paleksey/Automated-Blinds/enclosure/motor enclosure/render-2.png

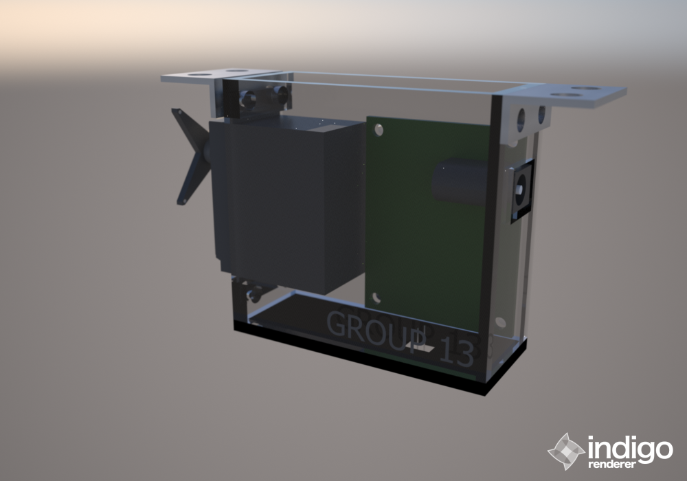
enclosure/motor enclosure/render-2.png
