paleksey/Automated-Blinds/enclosure/motor enclosure/render-1.png

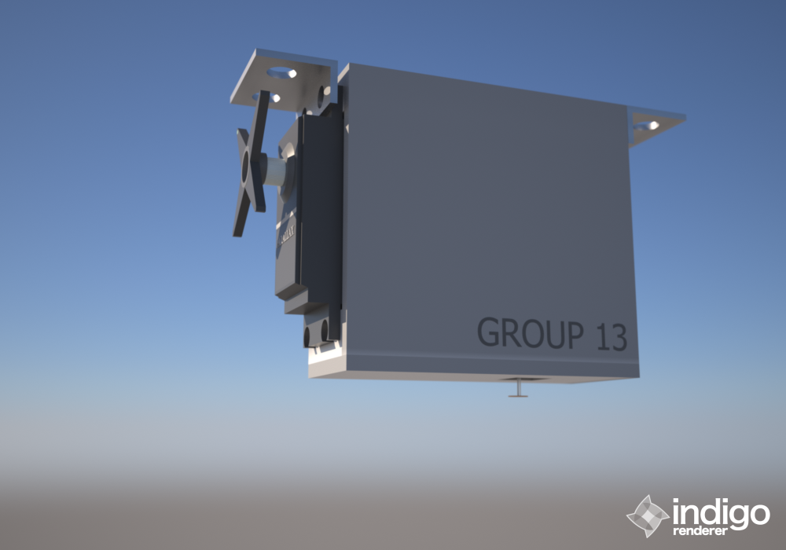
enclosure/motor enclosure/render-1.png
