paleksey/Automated-Blinds/README.md

# Automated-Blinds
This is a project design where we will design and build blinds that close and open automatically based on the light intensity outside.
