paleksey/Automated-Blinds/documents/T13-HOMEWORK-4.pdf

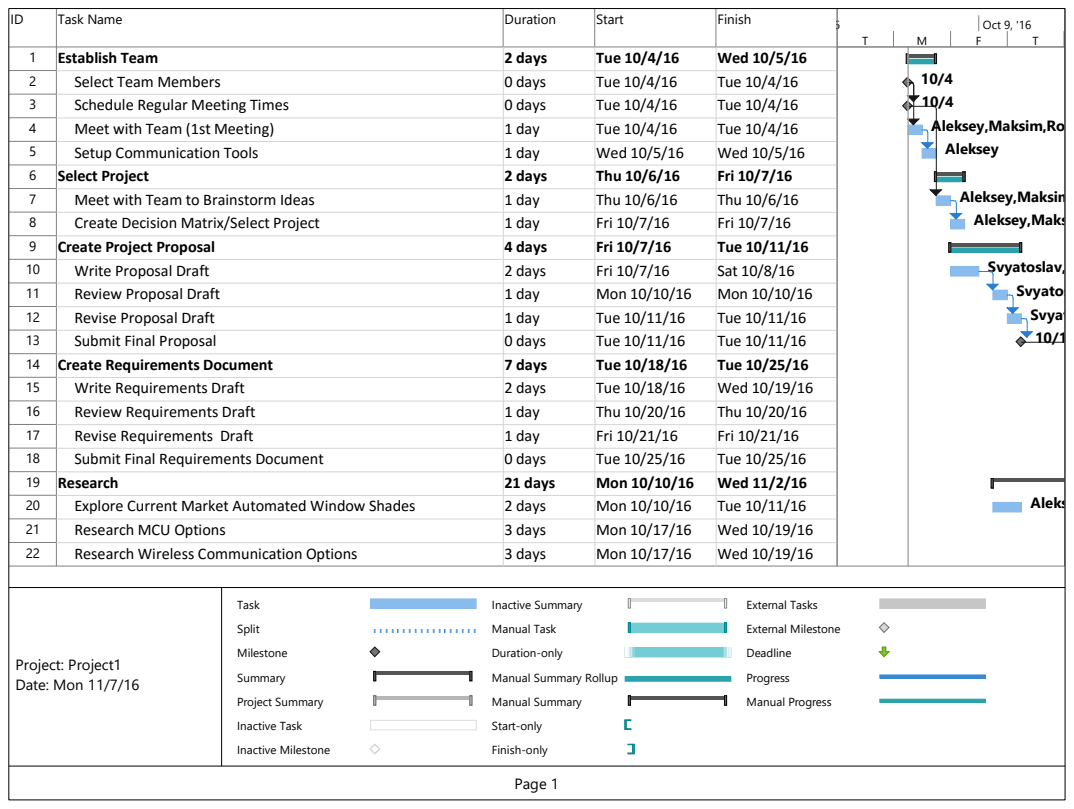
[picture p6: page 1]
Task Name; Duration; Start; Finish; Establish Team; 2 days; Tue 10/4/16; Wed 10/5/16; Select Team Members; 0 days; Schedule Regular Meeting Times; Meet with Team (1st Meeting); 1 day; Setup Communication Tools; Select Project; Thu 10/6/16; Fri 10/7/16; Meet with Team to Brainstorm Ideas; Create Decision Matrix/Select Project; Create Project Proposal; 4 days; Tue 10/11/16; Write Proposal Draft; Sat 10/8/16; Review Proposal Draft; Mon 10/10/16; Revise Proposal Draft; Submit Final Proposal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

Aleksey,Maksim,Roman,Svyatoslav
Aleksey,Maksim,Roman

Manual Summary Rollup

23 | Research Window Shades Actuator Options | 1 day | Thu 10/27/16 | Thu 10/27/16
24 | Research Schematic Capture Software Options | 1 day | Mon 10/10/16 | Mon 10/10/16
25 | Research MCU Programing Tools | 3 days | Mon 10/31/16 | Wed 11/2/16
26 | Design Window Shade Mechanism | 8 days | Fri 10/21/16 | Fri 10/28/16
27 | Brainstorm Enclosure/Mechanism Ideas | 3 days | Fri 10/21/16 | Sun 10/23/16
28 | Draw Concept Sketches | 2 days | Mon 10/24/16 | Tue 10/25/16
29 | Meet with Team to Select Final Mechanism Approach | 1 day | Wed 10/26/16 | Wed 10/26/16
30 | Create 3D Model of PCB Enclosure | 2 days | Thu 10/27/16 | Fri 10/28/16
31 | Create 3D Model of Demo Unit | 1 day | Thu 10/27/16 | Thu 10/27/16
32 | Design Preliminary Schematic | 11 days | Fri 10/14/16 | Wed 10/26/16
33 | Download Schematic Capture Software | 1 day | Fri 10/14/16 | Fri 10/14/16
34 | Create Functional Block Diagram for Circuit | 2 days | Mon 10/24/16 | Tue 10/25/16
35 | Create Preliminary Schematic | 7 days | Thu 10/20/16 | Wed 10/26/16
36 | Design PCB Power Circuit | 1 day | Wed 10/26/16 | Wed 10/26/16
37 | Design MCU Operation Circuit | 1 day | Thu 10/20/16 | Thu 10/20/16
38 | Design Device I/O Circuitry | 1 day | Fri 10/21/16 | Fri 10/21/16
39 | Select Prototyping Parts | 2 days | Sat 10/22/16 | Sun 10/23/16
40 | Create Prototyping BOM | 1 day | Mon 10/24/16 | Mon 10/24/16
41 | Order Prototyping Parts | 1 day | Tue 10/25/16 | Tue 10/25/16
42 | Prototype Project | 8 days | Wed 10/26/16 | Thu 11/3/16
43 | Build Prototype | 3 days | Wed 10/26/16 | Fri 10/28/16
44 | Test Basic Functionality | 2 days | Sun 10/30/16 | Mon 10/31/16

Svyatoslav

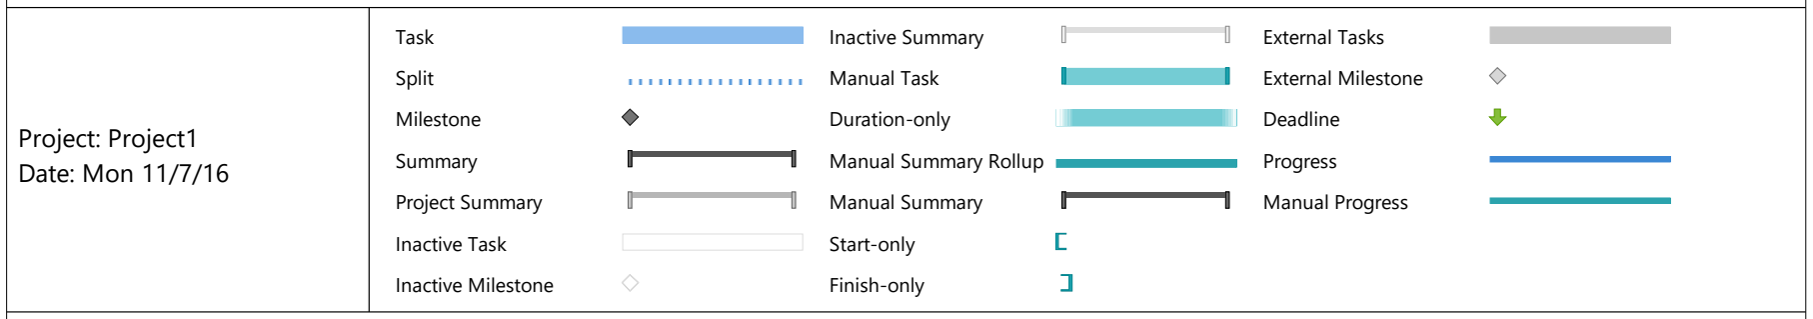
[picture p7: figure]
Task; Split; Milestone; Summary; Project Summary; Inactive Task; Inactive Milestone; Inactive Summary; Manual Task; Duration-only; Manual Summary Rollup; Manual Summary; Start-only; Finish-only; External Tasks; External Milestone; Deadline; Progress; Manual Progress; Project: Project1 Date: Mon 11/7/16

45 | Setup and Test Programing Tool | 2 days | Wed 10/26/16 | Thu 10/27/16
46 | Interface each Sensor and Actuator with MCU | 4 days | Mon 10/31/16 | Thu 11/3/16
47 | Revise Schematic Based on Prototyping | 1 day | Tue 11/1/16 | Tue 11/1/16
48 | Review Revised Schematic | 1 day | Wed 11/2/16 | Wed 11/2/16
49 | Upload Final Schematic | 0 days | Thu 11/3/16 | Thu 11/3/16
50 | Design PCB | 15 days | Fri 11/4/16 | Tue 11/22/16
51 | Select PCB Components | 4 days | Fri 11/4/16 | Tue 11/8/16
52 | Create PCB BOM | 1 day | Wed 11/9/16 | Wed 11/9/16
53 | Import Part Symbols and Footprints into Schematic Capture Tool | 2 days | Thu 11/10/16 | Fri 11/11/16
54 | Determine PCB Size | 1 day | Thu 11/10/16 | Thu 11/10/16
55 | Layout PCB | 3 days | Sat 11/12/16 | Tue 11/15/16
56 | Review Layout | 2 days | Wed 11/16/16 | Thu 11/17/16
57 | Route PCB | 2 days | Fri 11/18/16 | Mon 11/21/16
58 | Review Routing | 1 day | Tue 11/22/16 | Tue 11/22/16
59 | Review Gerber Files | 1 day | Tue 11/22/16 | Tue 11/22/16
60 | Submit PCB Files for Ordering | 0 days | Tue 11/22/16 | Tue 11/22/16
61 | Program MCU | 13 days | Wed 11/9/16 | Thu 11/24/16
62 | Write Pseudocode | 3 days | Wed 11/9/16 | Fri 11/11/16
63 | Translate Code to MCU Programing Language | 5 days | Sat 11/12/16 | Thu 11/17/16
64 | Run Code on Prototype Setup | 1 day | Fri 11/18/16 | Fri 11/18/16
65 | Debug Code | 3 days | Mon 11/21/16 | Wed 11/23/16
66 | Revise Code | 1 day | Thu 11/24/16 | Thu 11/24/16
| Task
| Split
| Milestone
| Summary
| Project Summary
| Inactive Task
| Inactive Milestone

Inactive Summary

Manual Task

Duration-only

Manual Summary Rollup

Manual Summary

Start-only

Finish-only

External Tasks

External Milestone

Deadline

Progress

Manual Progress

Project: Project1
Date: Mon 11/7/16

67 | Assemble Boards | 2 days | Wed 11/23/16 | Thu 11/24/16
68 | Assemble Window Shades for Demo | 4 days | Fri 11/25/16 | Wed 11/30/16
69 | Create PCB Enclosure | 2 days | Fri 11/25/16 | Mon 11/28/16
70 | Build Window Shade Mechanism | 2 days | Tue 11/29/16 | Wed 11/30/16
71 | Verify Project Requirements Have Been Met | 2 days | Thu 12/1/16 | Fri 12/2/16
72 | Test Ease of Use | 1 day | Thu 12/1/16 | Thu 12/1/16
73 | Conduct Stress Testing | 1 day | Thu 12/1/16 | Thu 12/1/16
74 | Test Long Term Functionality | 2 days | Thu 12/1/16 | Fri 12/2/16
75 | Create Final Project Documentation | 2 days | Mon 12/5/16 | Tue 12/6/16
76 | Review Documents | 1 day | Mon 12/5/16 | Mon 12/5/16
77 | Revise Documents | 1 day | Tue 12/6/16 | Tue 12/6/16
78 | Submit Final Documents | 0 days | Tue 12/6/16 | Tue 12/6/16
79 | Present Project | 1 day | Wed 12/7/16 | Wed 12/7/16

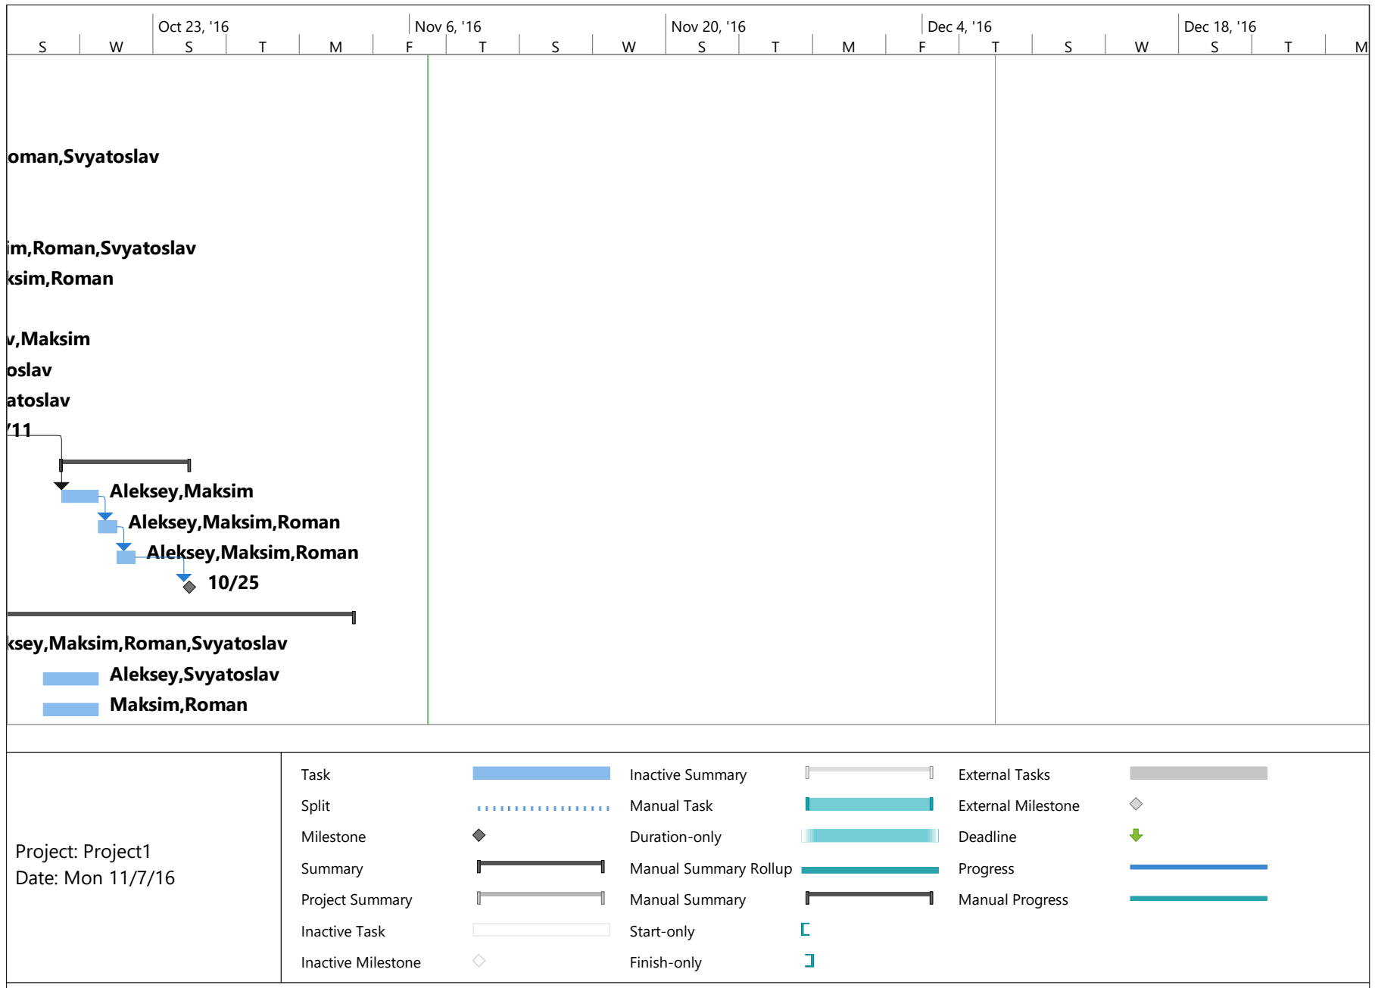
[picture p8: figure]
Aleksey,Maksim,Roman,Svyatoslav; Aleksey,Maksim,Roman; Svyatoslav,Maksim; Svyatoslav; Aleksey,Maksim; Aleksey,Svyatoslav; Maksim,Roman; Oct 23, '16; Nov 6, '16; Nov 20, '16; Dec 4, '16; Dec 18, '16; Task; Split; Milestone; Summary; Project Summary; Inactive Task; Inactive Milestone; Inactive Summary; Manual Task; Duration-only; Manual Summary Rollup; Manual Summary; Start-only; Finish-only; External Tasks; External Milestone; Deadline; Progress; Manual Progress; Project: Project1 Date: Mon 11/7/16
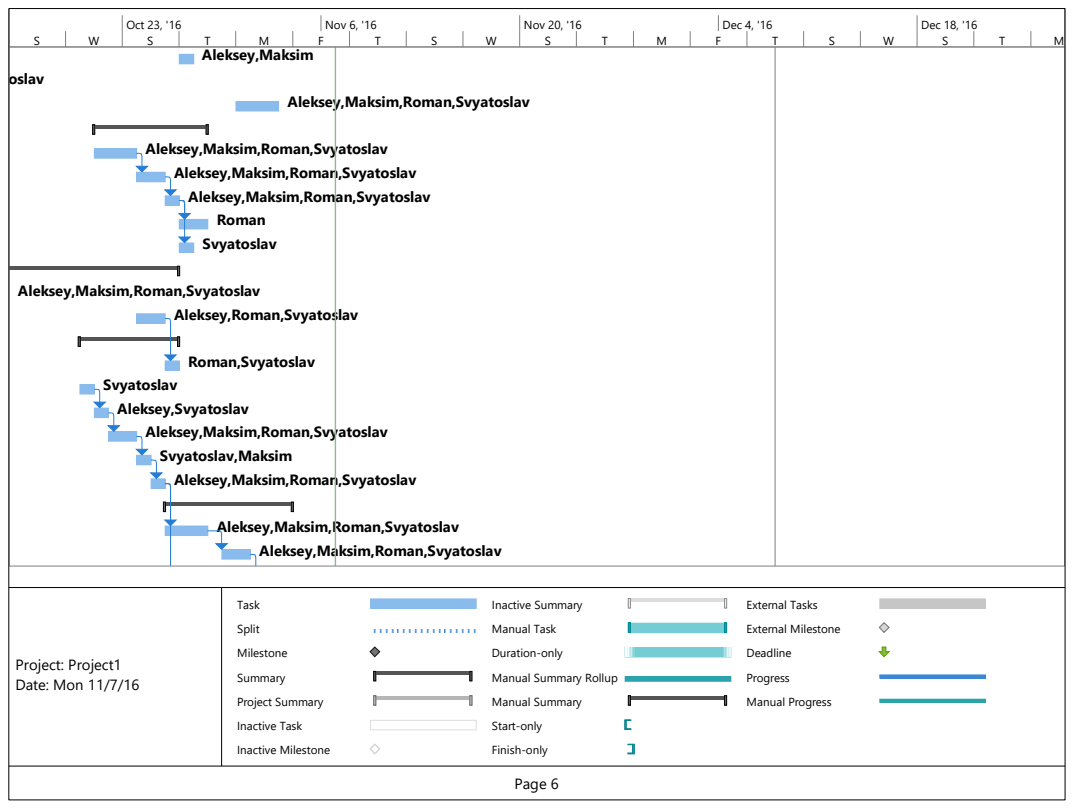
[picture p9: page 6]
Aleksey,Maksim; Svyatoslav; Roman,Svyatoslav; Task; Split; Milestone; Summary; Project Summary; Inactive Task; Inactive Milestone; Inactive Summary; Manual Task; Duration-only; Manual Summary; Start-only; Finish-only; External Tasks; External Milestone; Deadline; Progress; Manual Progress; Project: Project1 Date: Mon 11/7/16

Aleksey,Maksim,Roman,Svyatoslav

Roman
Svyatoslav

Aleksey,Roman,Svyatoslav

Aleksey,Svyatoslav
Svyatoslav,Maksim

Manual Summary Rollup

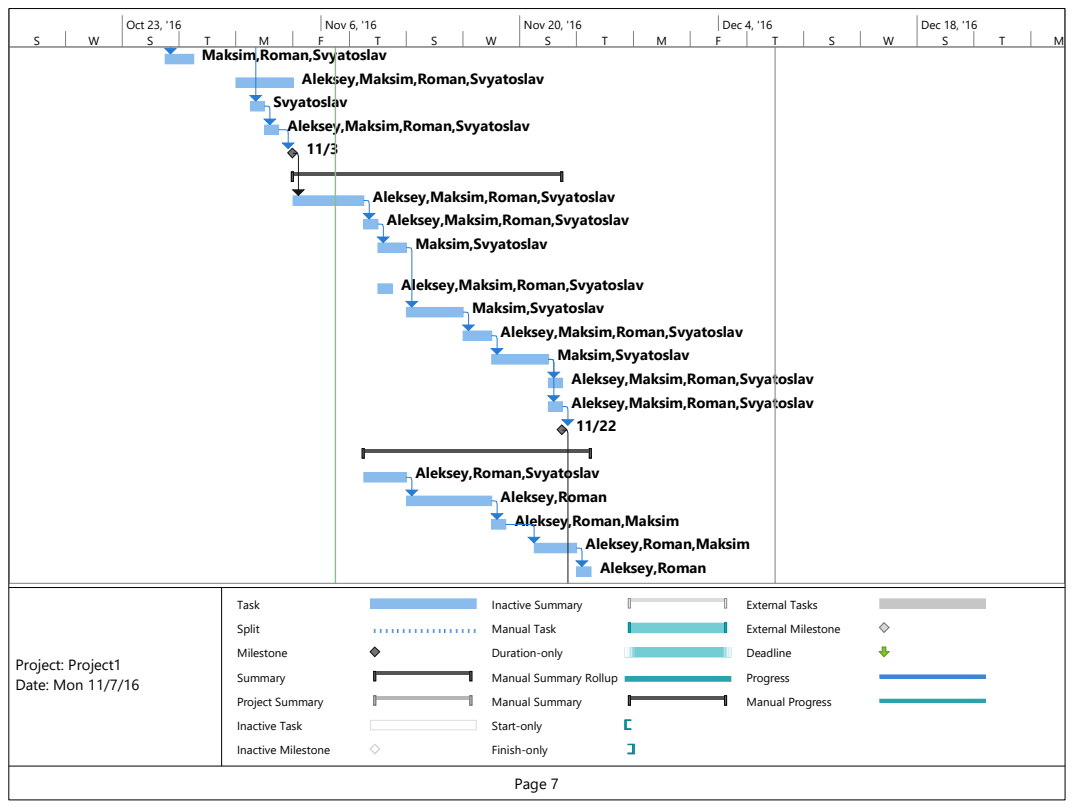
[picture p10: page 7]
Task; Split; Milestone; Summary; Project Summary; Inactive Task; Inactive Milestone; Inactive Summary; Manual Task; Duration-only; Manual Summary; Start-only; Finish-only; External Tasks; External Milestone; Deadline; Progress; Manual Progress; Project: Project1 Date: Mon 11/7/16

Maksim,Roman,Svyatoslav

Aleksey,Maksim,Roman,Svyatoslav
Svyatoslav

Maksim,Svyatoslav

Aleksey,Roman,Svyatoslav

Aleksey,Roman
Aleksey,Roman,Maksim

Manual Summary Rollup

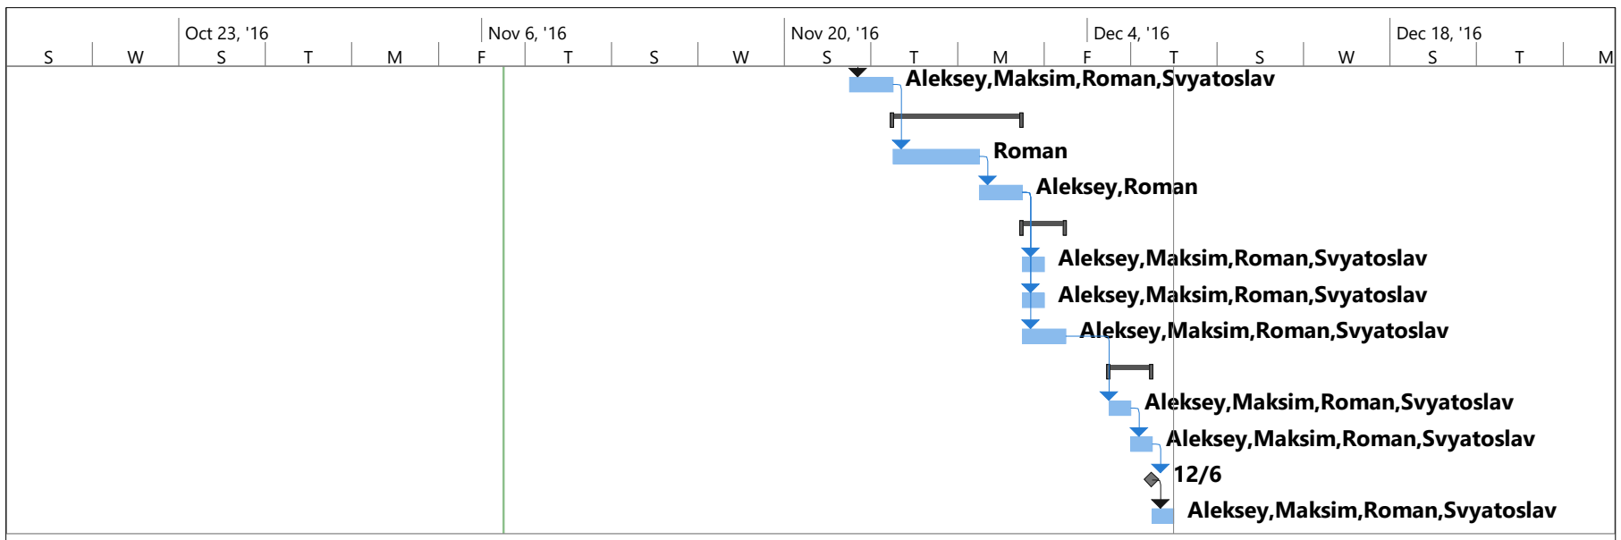
[picture p11: figure]
Aleksey,Maksim,Roman,Svyatoslav; Roman; Aleksey,Roman
