paleksey/Automated-Blinds/schematics-and-layout/411 Project Concept.png

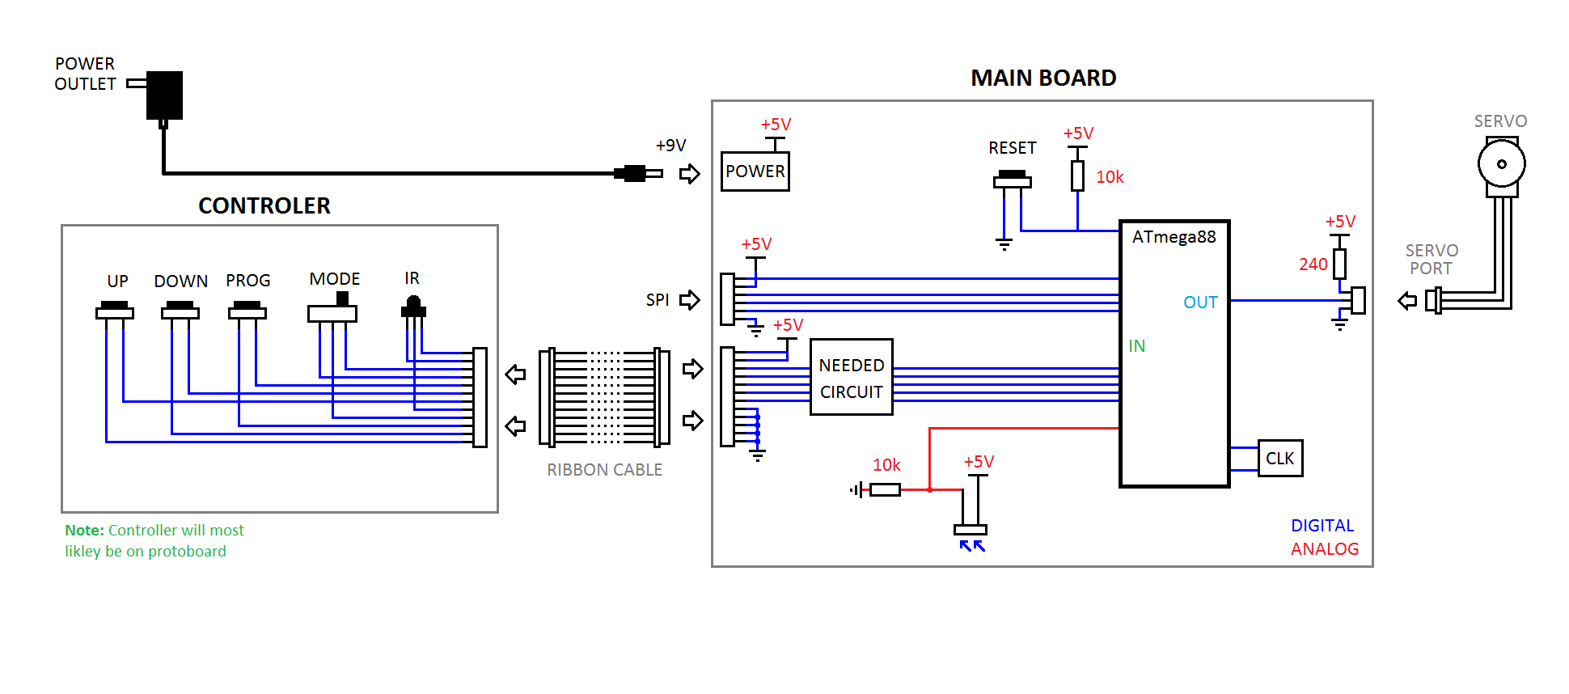
schematics-and-layout/411 Project Concept.png
