paleksey/Automated-Blinds/documents/PCB BOM.xlsx

Designator | Part Description | Parameters | Manufacturer Part Number | Qty | Qty 1 Cost | Total Cost | Order Status | Total Prototyping Cost | $19.12
U1 | 8-bit Microcontroller | 32 - TQFP | ATMEGA88-20AURCT-ND | 4 | $4.78 | $19.12 | Ordered | Cost Per Person | $4.78
 | Servo |  |  | 1 |  | $0.00
 |  |  |  |  |  | $0.00
 |  |  |  |  |  | $0.00
 |  |  |  |  |  | $0.00
 |  |  |  |  |  | $0.00
 |  |  |  |  |  | $0.00
 |  |  |  |  |  | $0.00
 |  |  |  |  |  | $0.00
 |  |  |  |  |  | $0.00
 |  |  |  |  |  | $0.00
 |  |  |  |  |  | $0.00
 |  |  |  |  |  | $0.00
 |  |  |  |  |  | $0.00
 |  |  |  |  |  | $0.00
 |  |  |  |  |  | $0.00
 |  |  |  |  |  | $0.00
 |  |  |  |  |  | $0.00
 |  |  |  |  |  | $0.00
 |  |  |  |  |  | $0.00
 |  |  |  |  |  | $0.00
 |  |  |  |  |  | $0.00
 |  |  |  |  |  | $0.00
 |  |  |  |  |  | $0.00
 |  |  |  |  |  | $0.00
 |  |  |  |  |  | $0.00
 |  |  |  |  |  | $0.00
 |  |  |  |  |  | $0.00
 |  |  |  |  |  | $0.00
 |  |  |  |  |  | $0.00
 |  |  |  |  |  | $0.00
 |  |  |  |  |  | $0.00
 |  |  |  |  |  | $0.00
 |  |  |  |  |  | $0.00
 |  |  |  |  |  | $0.00
 |  |  |  |  |  | $0.00
 |  |  |  |  |  | $0.00
 |  |  |  |  |  | $0.00
 |  |  |  |  |  | $0.00
 |  |  |  |  |  | $0.00
 |  |  |  |  |  | $0.00
 |  |  |  |  |  | $0.00
 |  |  |  |  |  | $0.00
 |  |  |  |  |  | $0.00
 |  |  |  |  |  | $0.00
 |  |  |  |  |  | $0.00
 |  |  |  |  |  | $0.00
 |  |  |  |  |  | $0.00
 |  |  |  |  |  | $0.00
