paleksey/Automated-Blinds/(list of files, cad)

Other CAD files:
enclosure/controller enclosure/Controller Enclosure.SLDPRT
enclosure/motor enclosure/enclosure - laser cut out.skp
enclosure/motor enclosure/enclosure without board.skp
enclosure/motor enclosure/window.skp
