paleksey/Automated-Blinds/schematics-and-layout/T13-schematic.pdf

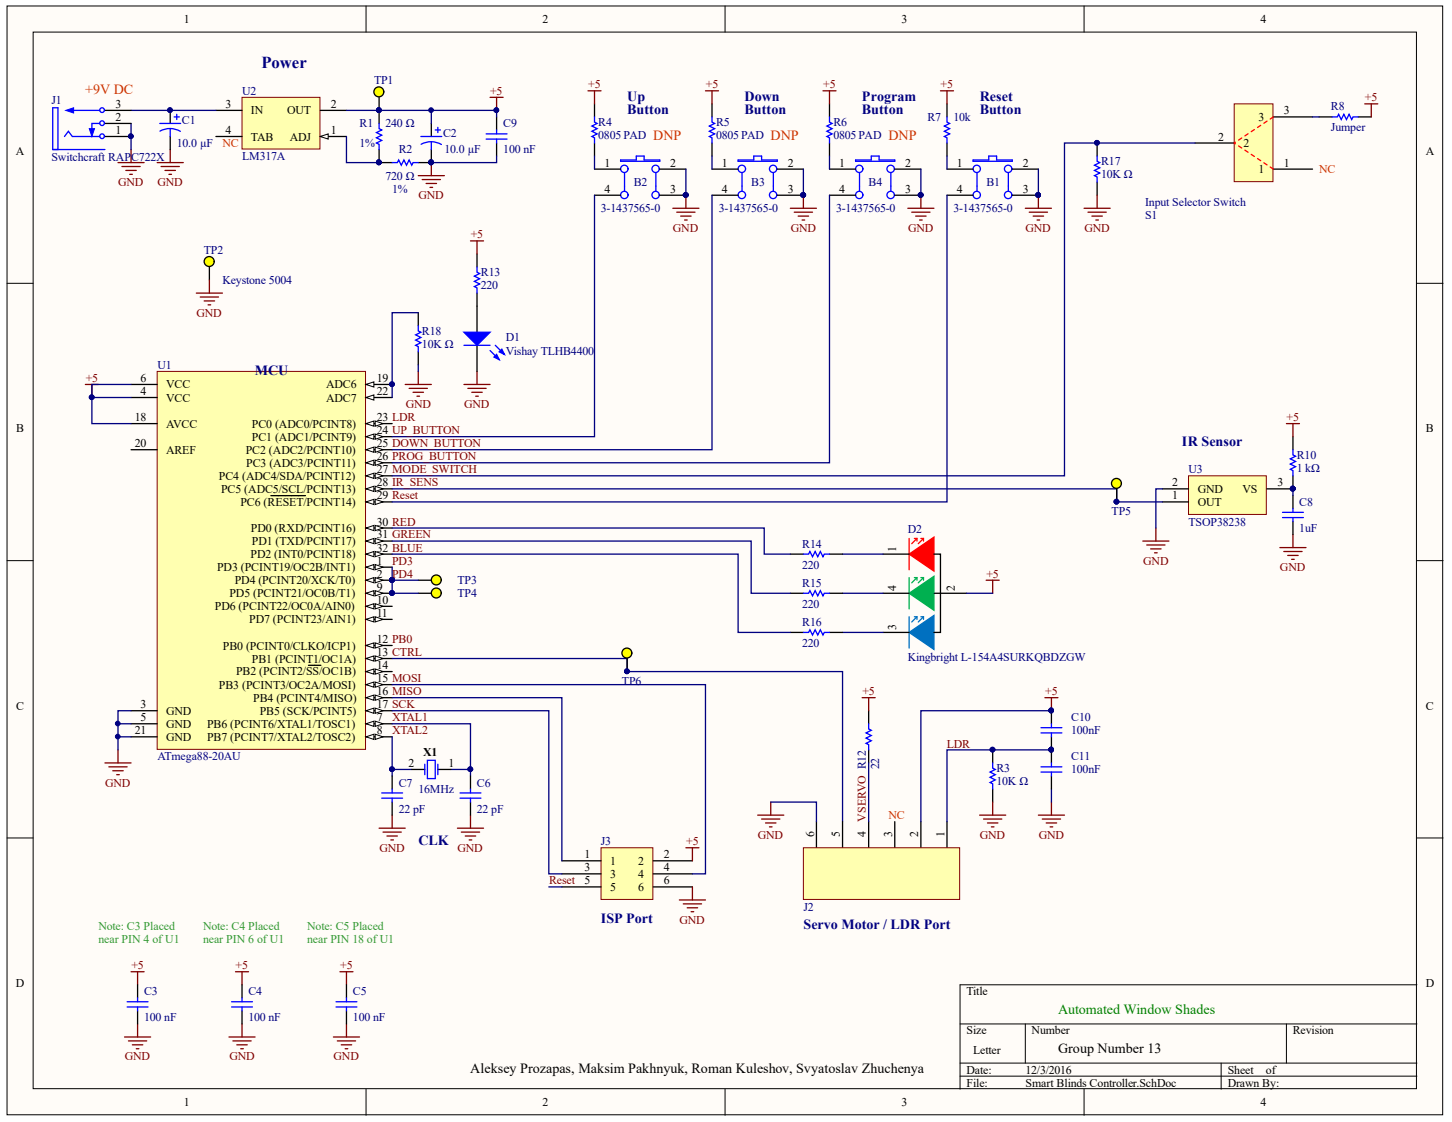
[picture p13: page 1]

UP_BUTTON | GND +5 GND | R13 220

AVCC 18 | GND LDR

IR_SENS
Reset

GREEN
BLUE
PD3
PD4

MOSI TP6
MISO
SCK

Servo Motor / LDR Port

Aleksey Prozapas, Maksim Pakhnyuk, Roman Kuleshov, Svyatoslav Zhuchenya
