paleksey/Automated-Blinds/enclosure/motor enclosure/enclosure - laser cut out.pdf

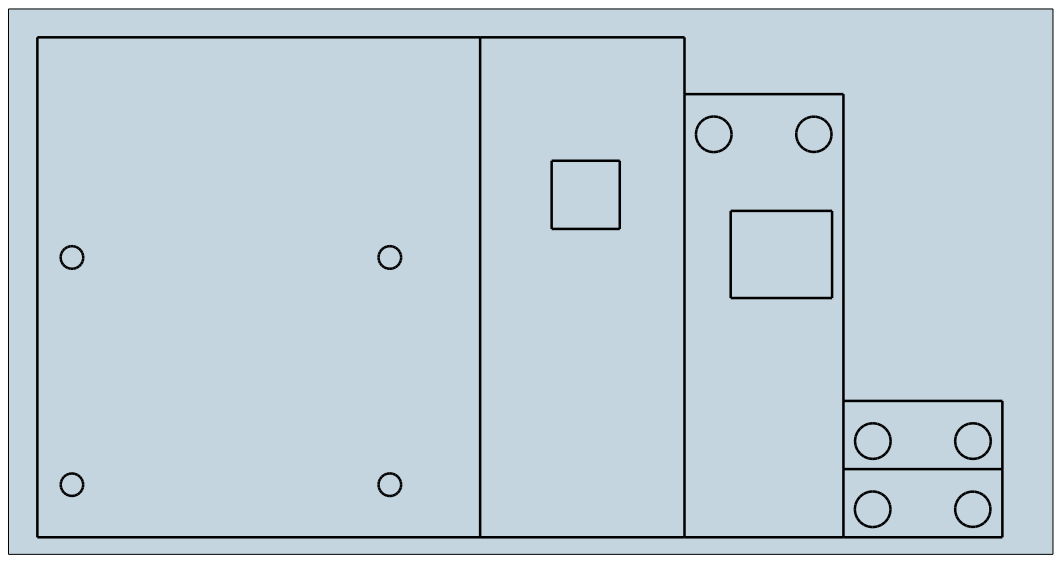
[picture p27: page 1]
