paleksey/Automated-Blinds/(commit log)

2016-11-02 Add the enclosure folder.
    [enclosure - laser cut out.skp, enclosure.skp, window.skp]
2016-11-03 Seperate docs and schematics into their own folders
    [PCB BOM.xlsx]
2016-11-06 Add files via upload
    Concept drawing of sensor and port placement
2016-11-11 Rename schematic file to follow proper convention
2016-11-11 Upload updated schematic
2016-11-11 Upload the layer by layer PDF printout
2016-11-11 Add CircuitMaker generated Gerber files
2016-11-21 Organize enclosure files; Add 3D model of PCB
    [enclosure - laser cut out.skp, enclosure.skp, window.skp]
2016-11-22 Create solid works 2D shape of enclosure
    [Controller Enclosure.SLDPRT]
2016-12-04 Create set up code and the polling interrupt block
2016-12-04 Fix build errors in code
    [main.c]
2016-12-05 Update schematic to current version
2016-12-07 Debug code with Max; Add RGB Led Driver Function
2016-12-07 Add motor enclosure that is without the board
    [enclosure without board.skp]
2016-12-07 Add an interupt vector the buttons
2016-12-07 Debug button interrupt procedure with Max
2016-12-08 Add servo motor code
2016-12-08 Debug up and programming button code
2016-12-08 Add variables to easily change servo PWM; Add down button code
2016-12-08 Add slide switch and IR remote code
2016-12-08 Enabling LDR, IR, and buttons
2016-12-08 Make mode selection switch work
2016-12-08 Fix slide switch LED
    [main.c]
2016-12-08 Fix the RGB LED
    [main.c]
